msx-consulting/amino/mom-s1/PCB/Output/MoM-S1_schematic_v1.0.6.pdf

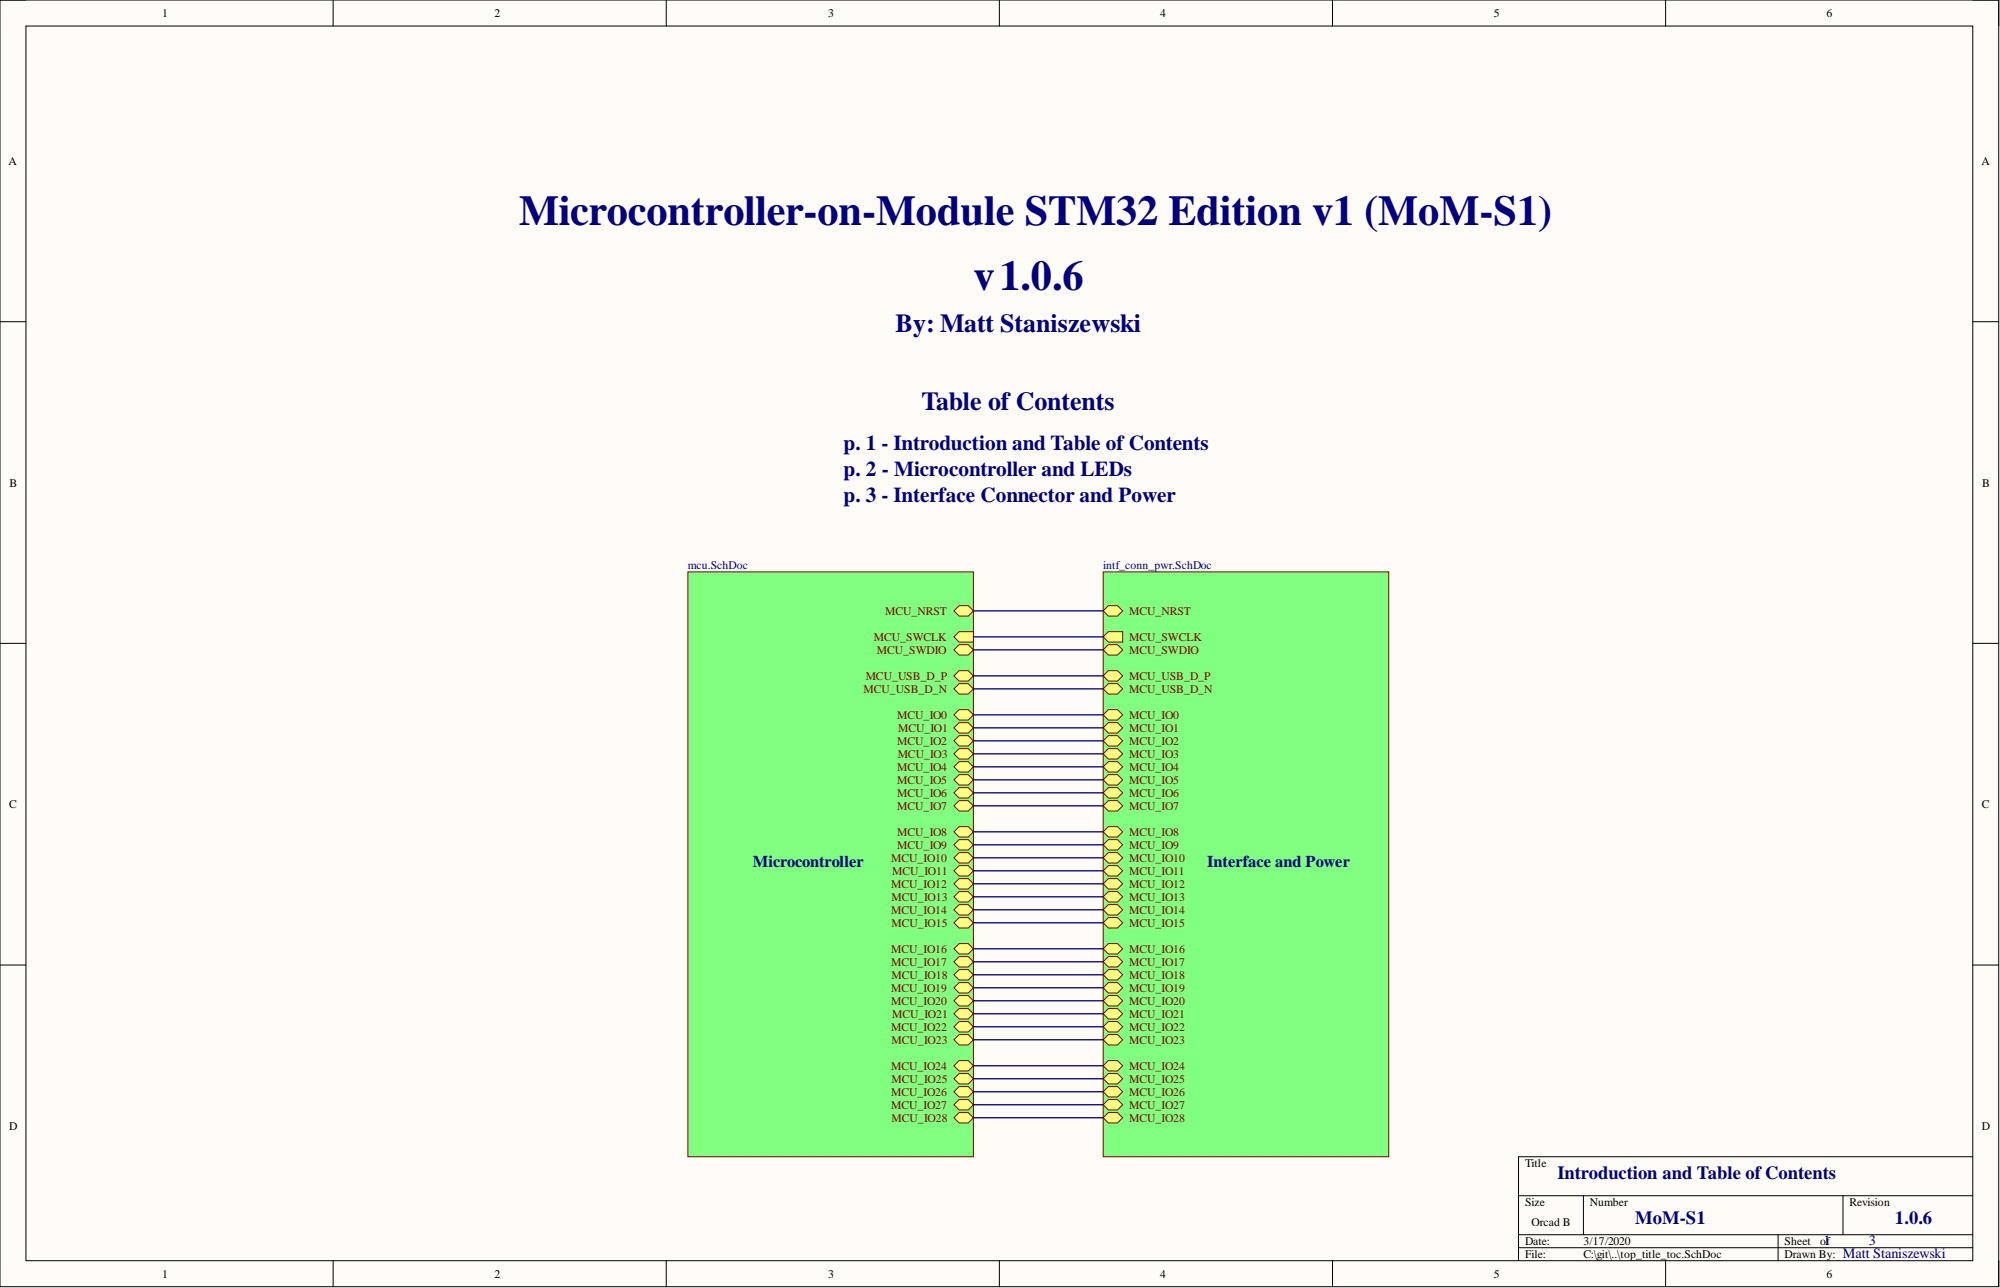
[picture p6: page 1]

Microcontroller-on-Module STM32 Edition v1 (MoM-S1)

p. 1 - Introduction and Table of Contents
p. 2 - Microcontroller and LEDs
p. 3 - Interface Connector and Power

Title
Introduction and Table of Contents

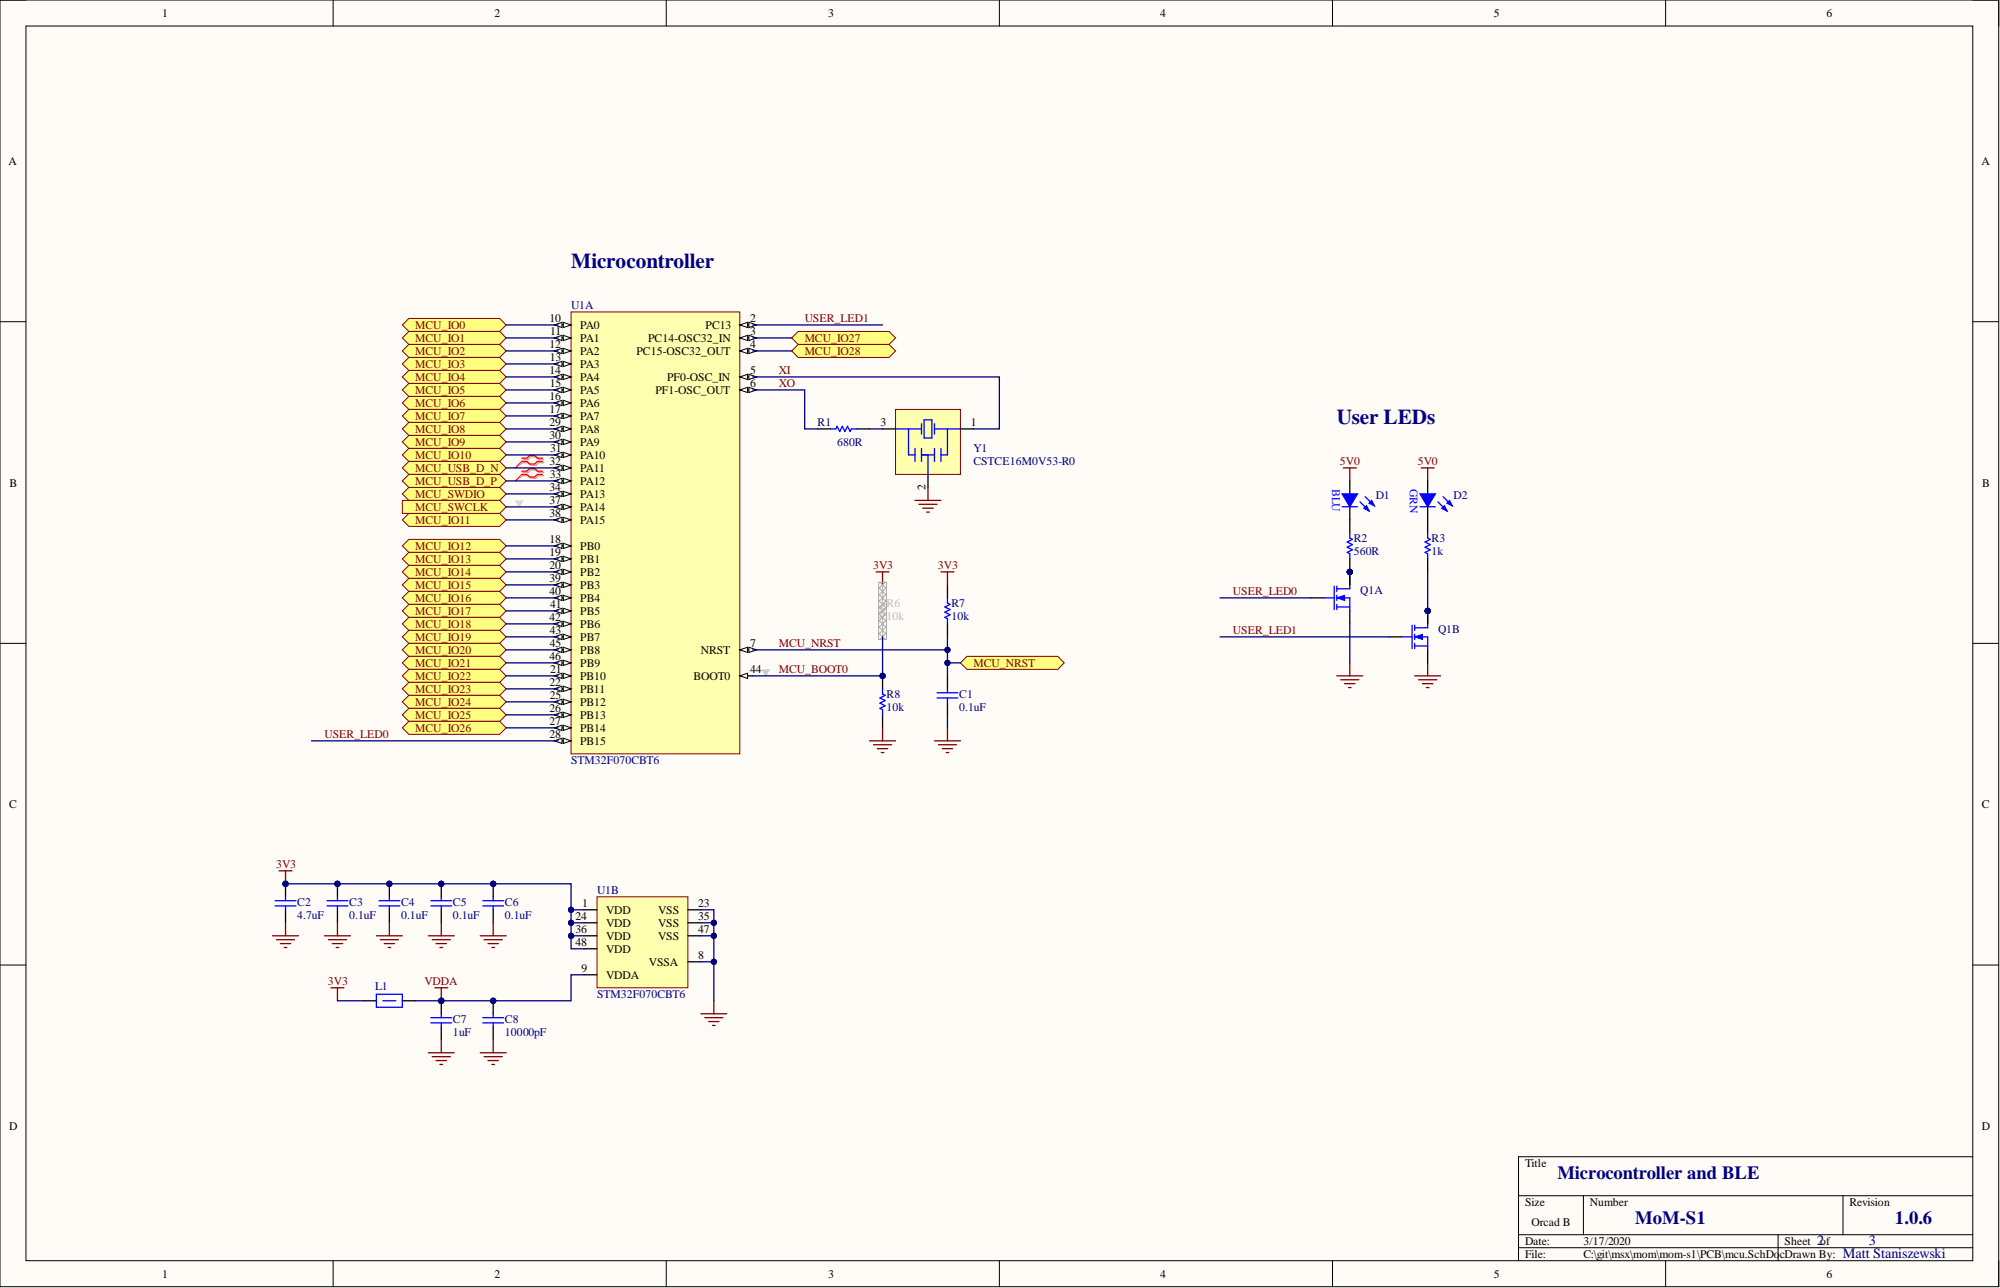
[picture p7: page 2]

MCU_NRST

MCU_BOOT0

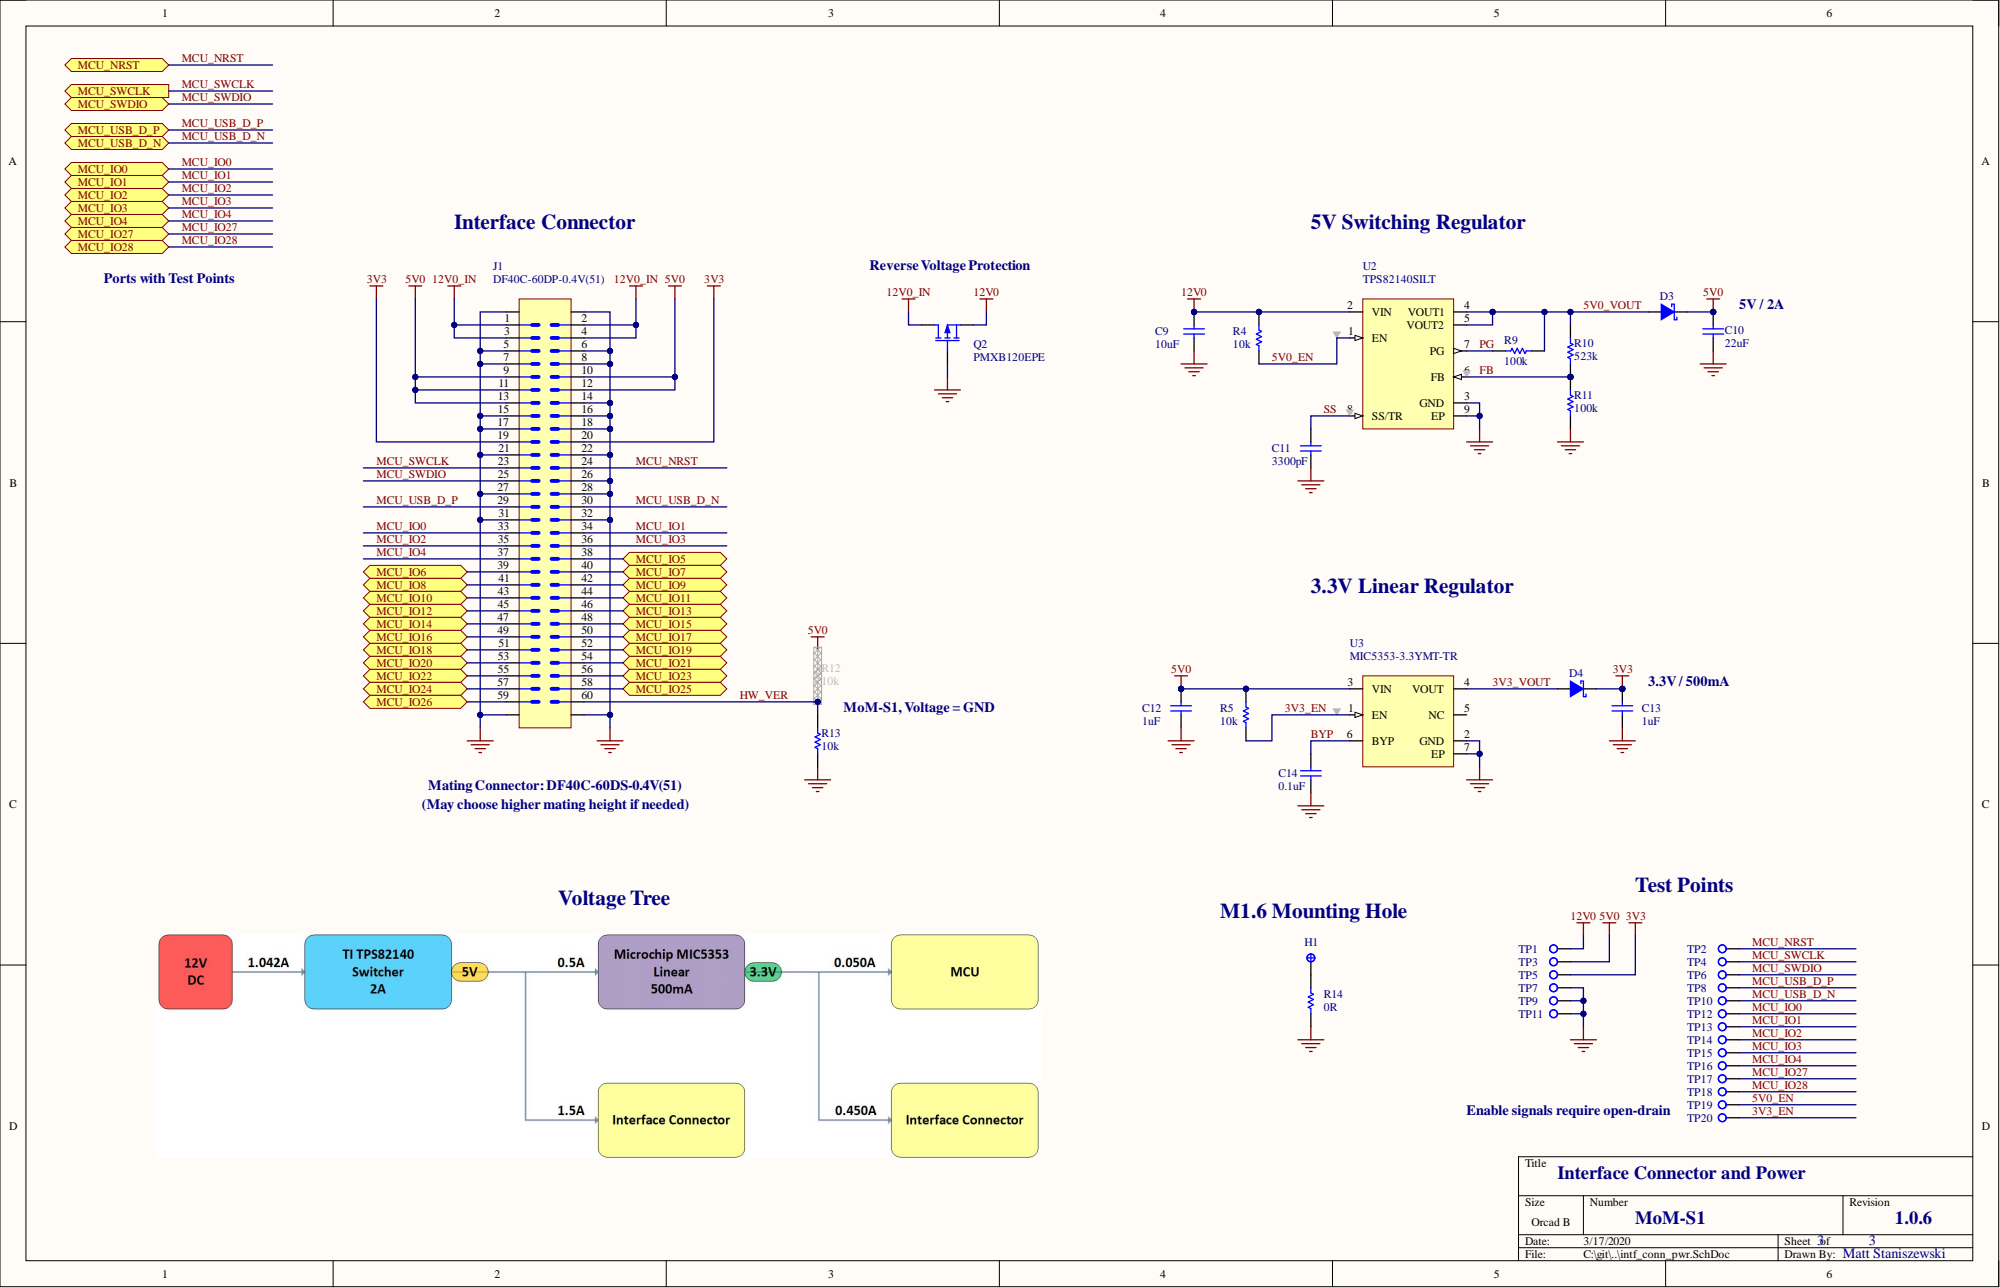
[picture p8: page 3]

Ports with Test Points

BYP

Mating Connector: DF40C-60DS-0.4V(51)
(May choose higher mating height if needed)

Title
Interface Connector and Power
