msx-consulting/amino/mom-s1/PCB/Output/MoM-S1_schematic_v1.0.3.pdf

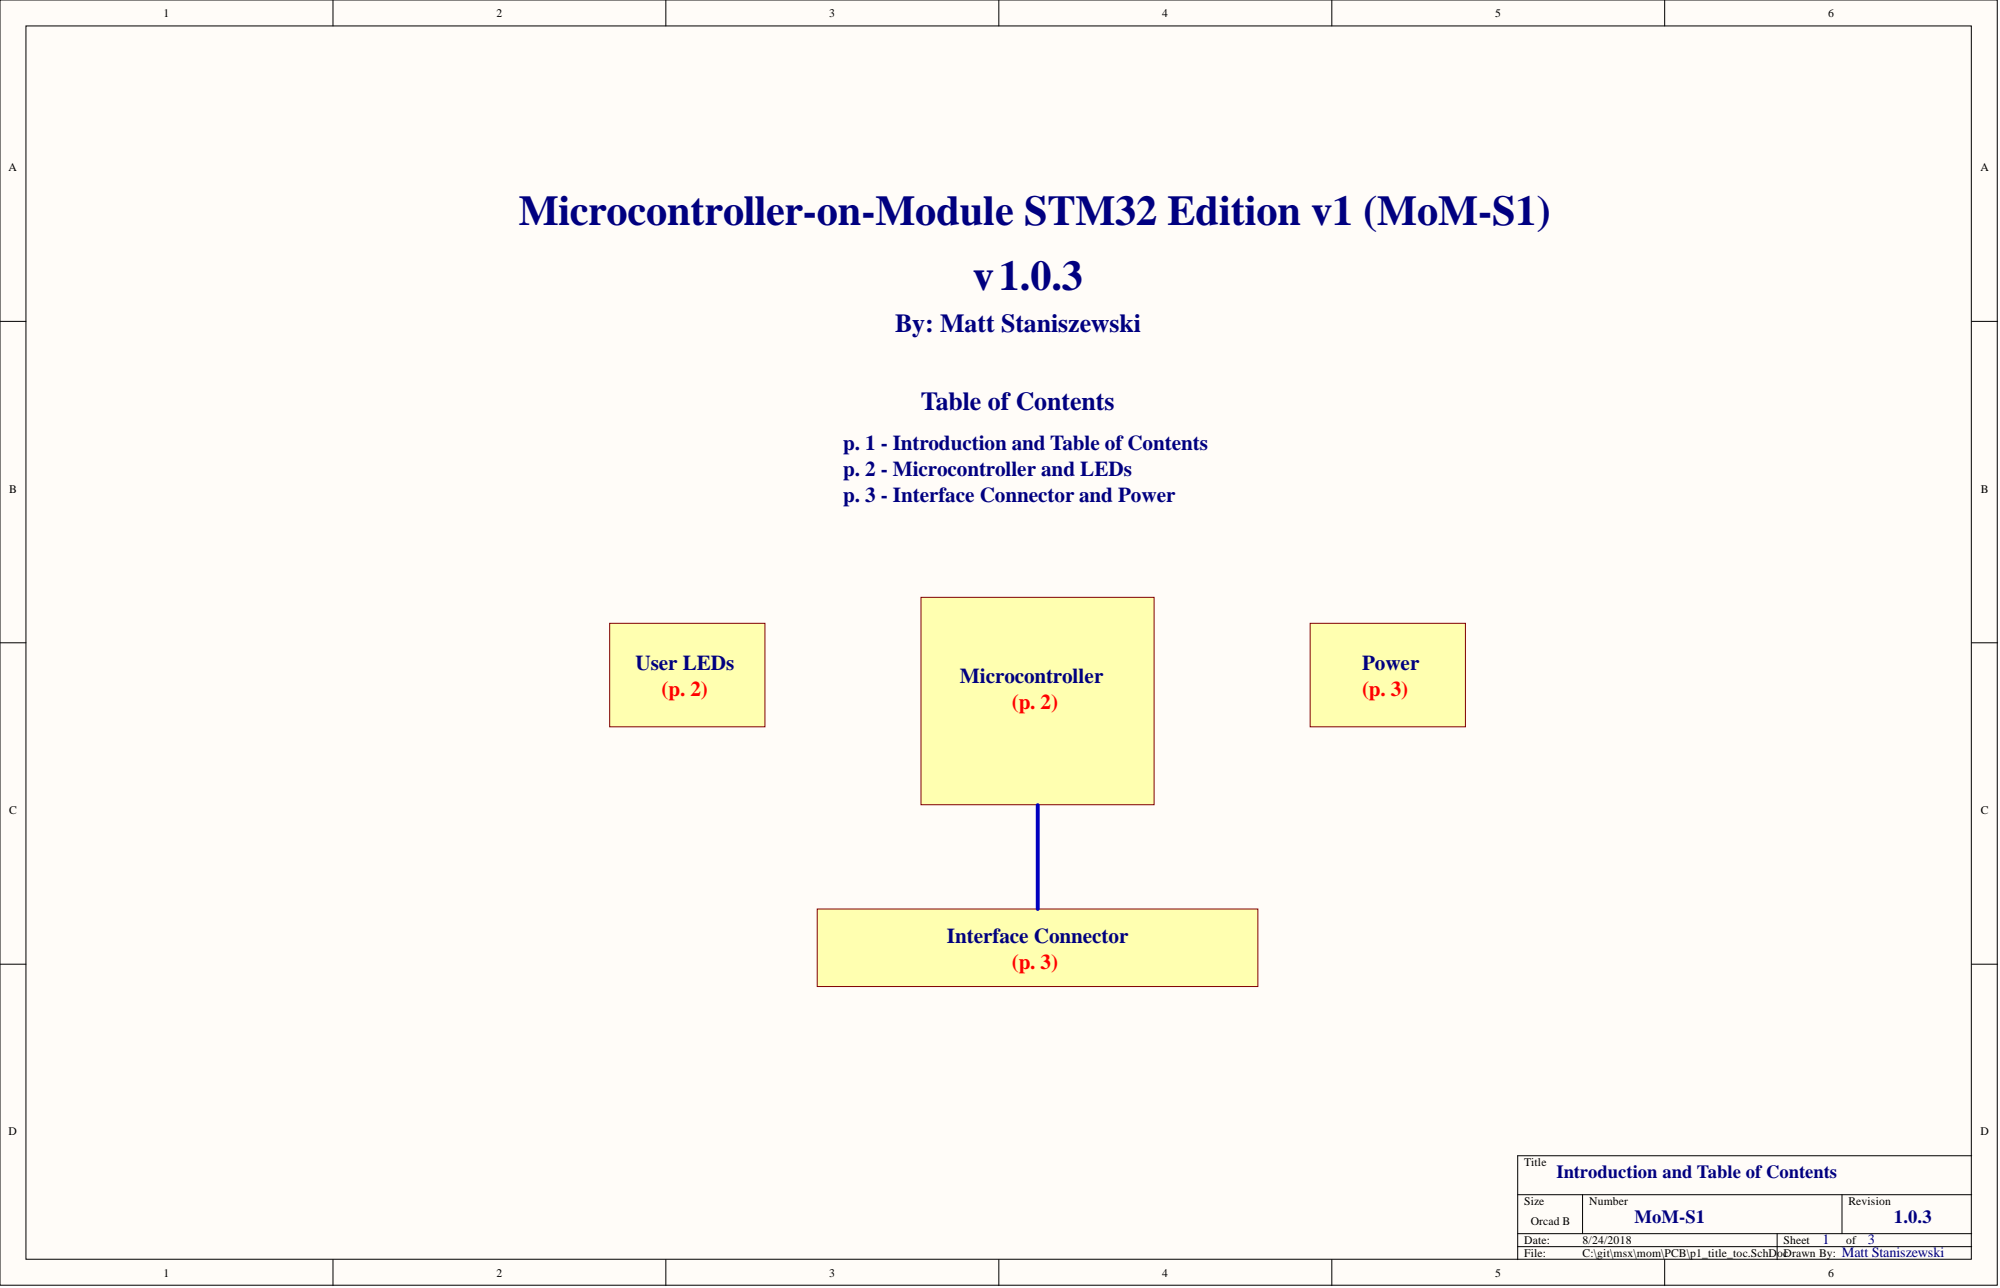
[picture p15: page 1]

Microcontroller-on-Module STM32 Edition v1 (MoM-S1)

p. 1 - Introduction and Table of Contents
p. 2 - Microcontroller and LEDs
p. 3 - Interface Connector and Power

Title
Introduction and Table of Contents

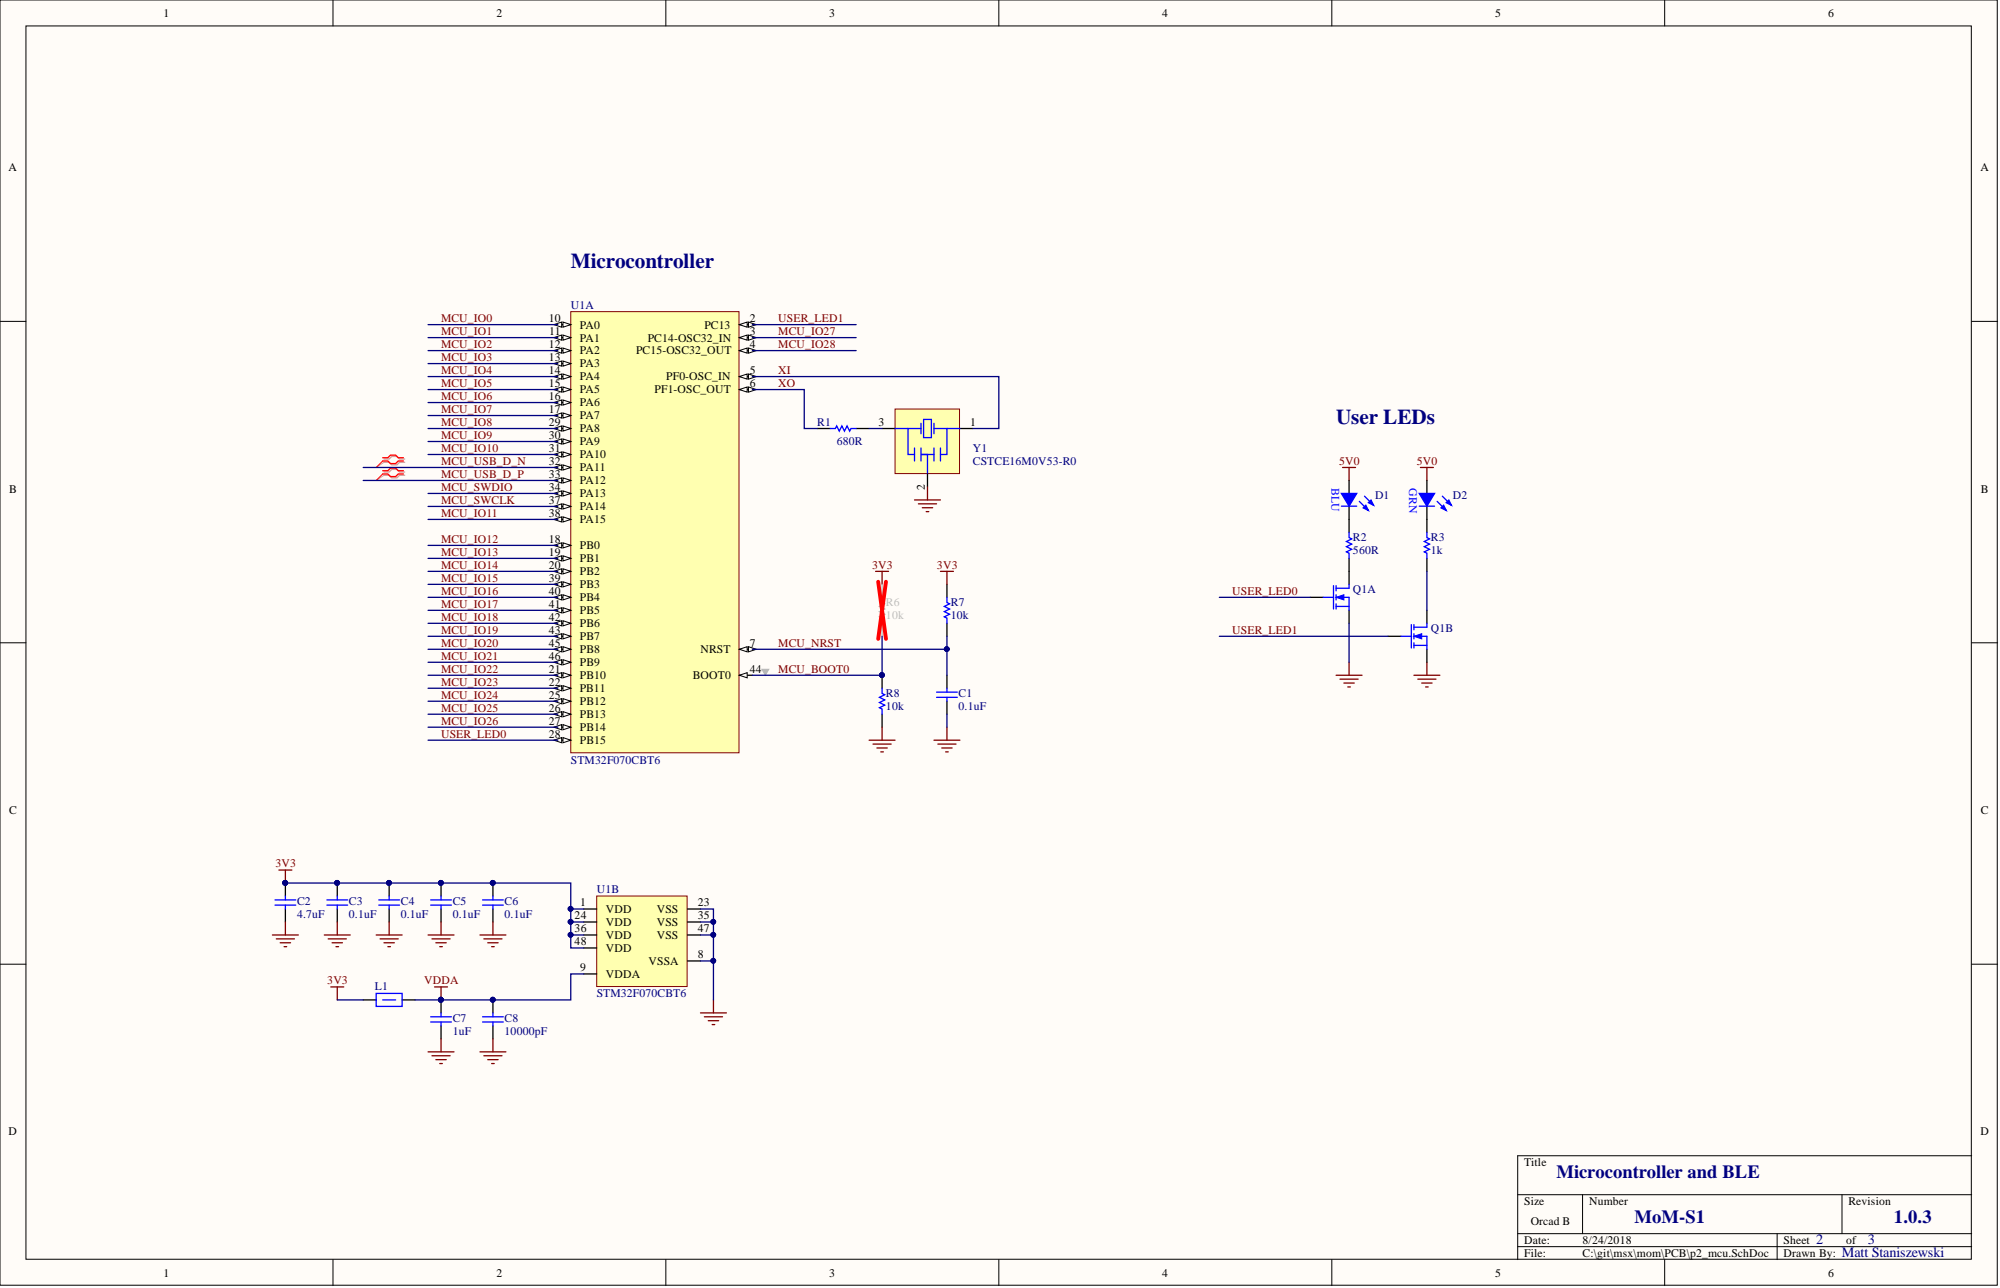
[picture p16: page 2]

7 MCU _ NRST

4 4 MCU _BO O T 0

2 4 | 3 5
3 6 | 4 7
4 8 | 8

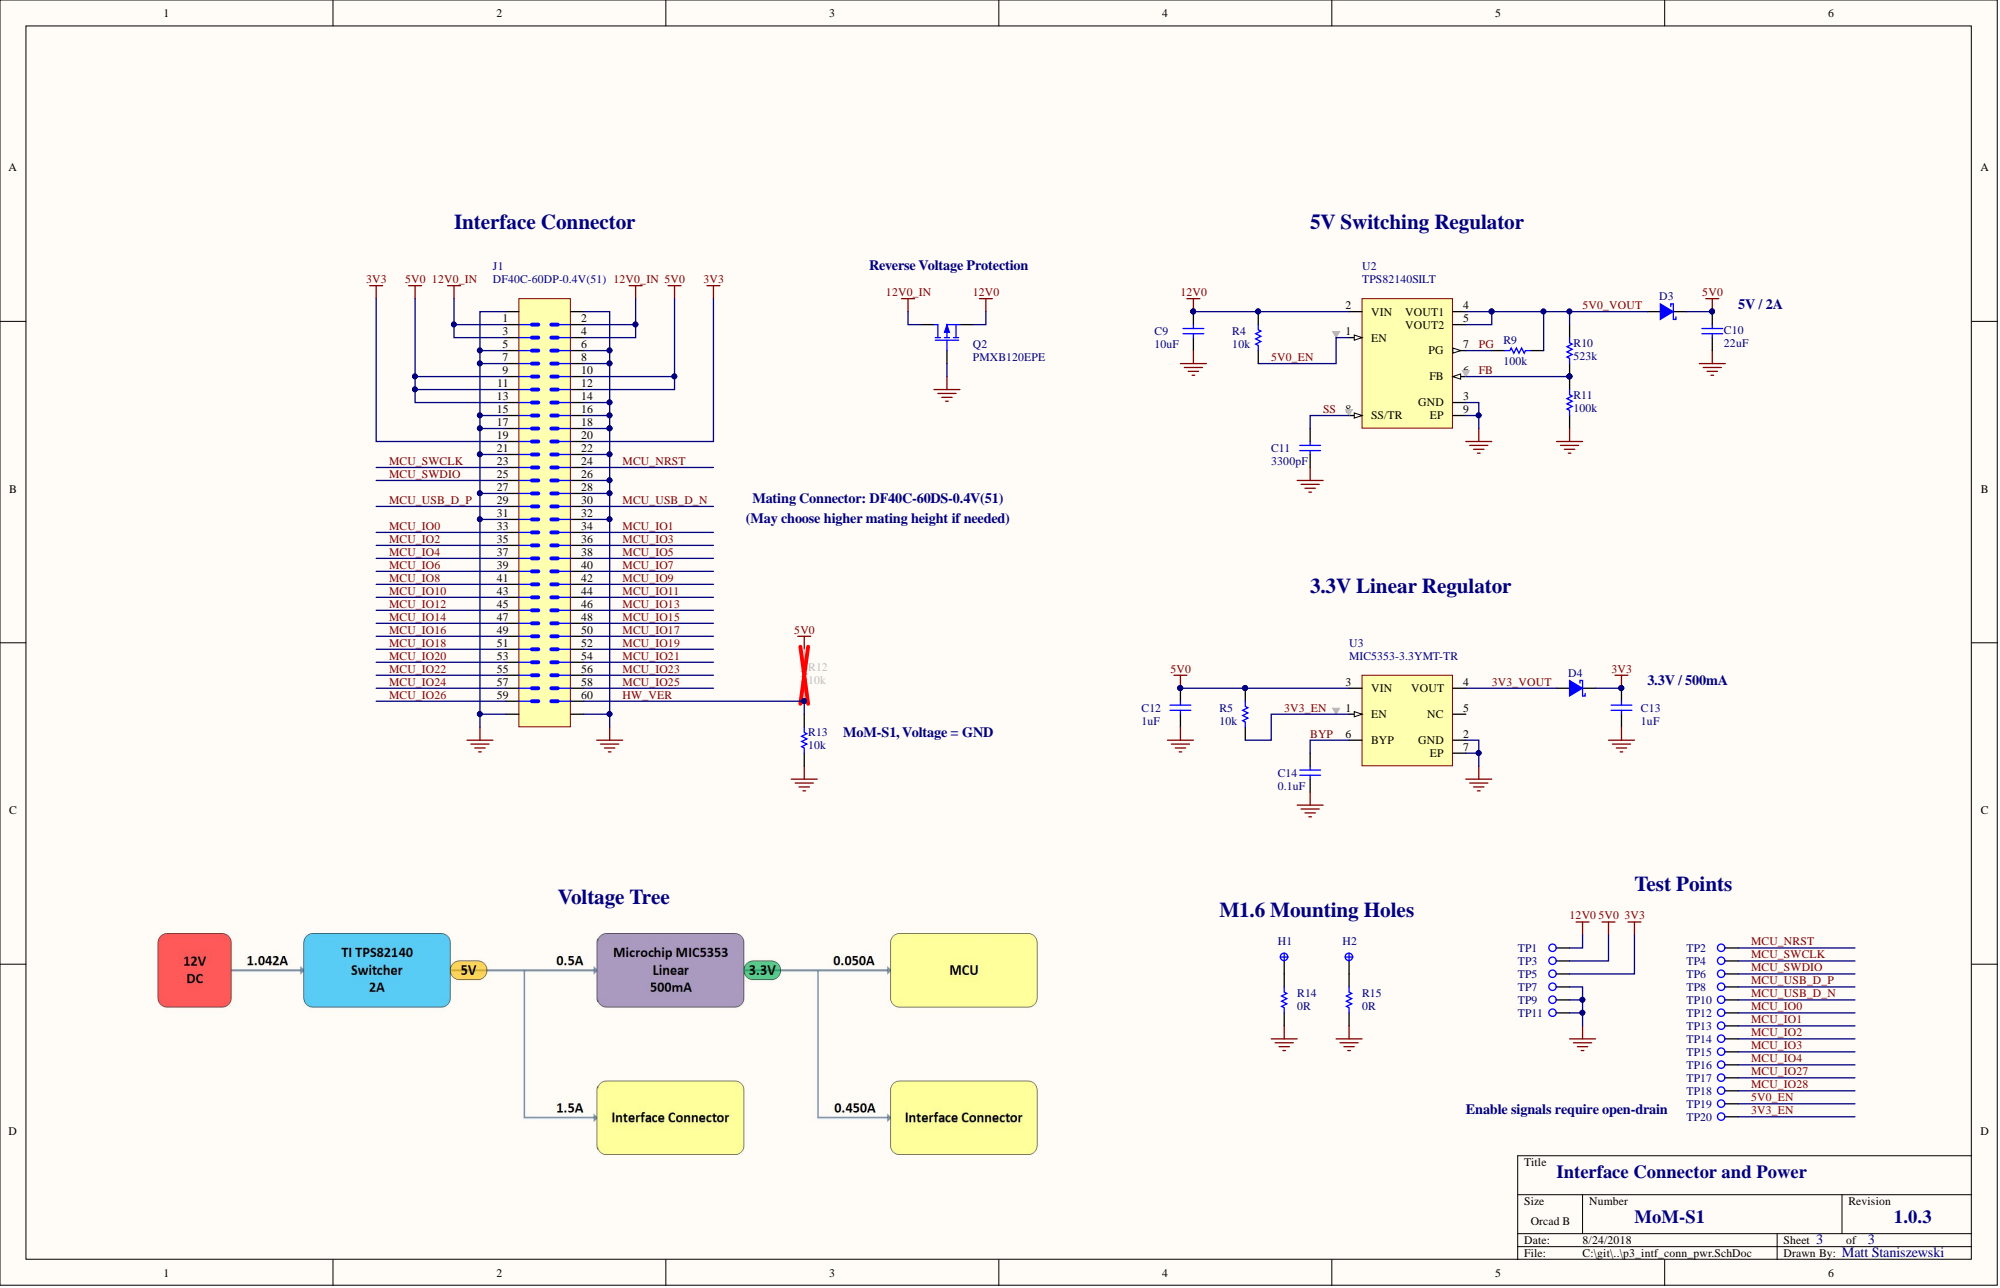
[picture p17: page 3]
