msx-consulting/amino/(list of files, drawings)

Other design files:
mom-s1/PCB/intf_conn_pwr.SchDoc
mom-s1/PCB/mcu.SchDoc
mom-s1/PCB/mom-s.PcbDoc
mom-s1/PCB/mom-s.PrjPcb
mom-s1/PCB/top_title_toc.SchDoc
UPDATE PCB/amino.PrjPcb
UPDATE PCB/p1_title_toc.SchDoc
UPDATE PCB/p2_mcu_ble.SchDoc
UPDATE PCB/p3_intf_conn_pwr.SchDoc
