msx-consulting/amino/(commit log)

2017-09-19 Move git repo from personal to MSX
    [Interface Connector Pinout.xlsx]
2017-09-19 Added Hisory to ignore
    [amino.PrjPcb, p1_title_toc.SchDoc, p2_mcu_ble.SchDoc, p3_intf_conn.SchDoc, p4_pwr_misc.SchDoc]
2017-09-19 Add schmatic page structure
    [amino.PrjPcb, p2_mcu_ble.SchDoc, p3_intf_conn.SchDoc, p4_pwr_misc.SchDoc]
2017-09-19 Started wiring up MCU
    [amino.PrjPcb, p1_title_toc.SchDoc, p2_mcu_ble.SchDoc, p3_intf_conn.SchDoc, p4_pwr_misc.SchDoc]
2017-09-20 FTDI chip hooked up for USB UART
    [Interface Connector Pinout.xlsx, amino.PrjPcb, p1_title_toc.SchDoc, p2_mcu_ble.SchDoc, p3_intf_conn.SchDoc, p4_pwr_misc.SchDoc]
2017-09-22 Sch in progress
    [p1_title_toc.SchDoc, p2_mcu_ble.SchDoc, p3_intf_conn.SchDoc, p4_pwr_misc.SchDoc]
2017-09-23 Cleaning up sch, almost done with Amino
    [amino.PrjPcb, p1_title_toc.SchDoc, p2_mcu_ble.SchDoc, p3_intf_conn.SchDoc, p3_intf_conn_pwr.SchDoc, p4_pwr_misc.SchDoc]
2017-09-23 More elegant USB power solution added
    [amino.PrjPcb, p2_mcu_ble.SchDoc]
2017-09-26 Notes review completed, prep for netlist review
    [Interface Connector Pinout.xlsx, amino.PrjPcb, p1_title_toc.SchDoc, p2_mcu_ble.SchDoc, p3_intf_conn_pwr.SchDoc]
2017-09-26 amINO (v1.0.1): Netlist review completed
    [amino.PrjPcb, p1_title_toc.SchDoc, p2_mcu_ble.SchDoc, p3_intf_conn_pwr.SchDoc]
2017-10-01 PCB started, stackup and rules done, placing
    [amino.PcbDoc, amino.PrjPcb, p1_title_toc.SchDoc, p2_mcu_ble.SchDoc, p3_intf_conn_pwr.SchDoc]
2017-10-10 Rough placement done, v1.0.2 in progress
    [amino.PcbDoc, amino.PrjPcb, p1_title_toc.SchDoc, p2_mcu_ble.SchDoc, p3_intf_conn_pwr.SchDoc]
2017-10-11 amINO (v1.0.2): Updates for placement
    [Bill of Materials-amino.csv, amino.PcbDoc, amino.PrjPcb, amino.xls, p1_title_toc.SchDoc, p2_mcu_ble.SchDoc, p3_intf_conn_pwr.SchDoc]
2017-10-17 Sync up for big compy
    [amino.PcbDoc, amino.PrjPcb, p2_mcu_ble.SchDoc]
2017-10-17 v1.0.3 in progress, C8 footprint changed
    [amino.PcbDoc, amino.PrjPcb, p1_title_toc.SchDoc, p2_mcu_ble.SchDoc, p3_intf_conn_pwr.SchDoc]
2017-10-31 Working on planes
    [amino.PcbDoc, amino.PrjPcb, p2_mcu_ble.SchDoc, p3_intf_conn_pwr.SchDoc]
2017-11-05 Swapping and fanning out the BGA
    [Interface Connector Pinout.xlsx, amino.PcbDoc, amino.PrjPcb, p1_title_toc.SchDoc, p2_mcu_ble.SchDoc, p3_intf_conn_pwr.SchDoc]
2017-11-05 Prep to remove USB power switch
    [amino.PcbDoc, p2_mcu_ble.SchDoc]
2017-11-05 Tossed USB switch, fixing AVCC, other rails
    [amino.PcbDoc, p1_title_toc.SchDoc, p2_mcu_ble.SchDoc, p3_intf_conn_pwr.SchDoc]
2018-05-11 Review notes, begin transition to MoM design
    [Interface Connector Pinout.xlsx]
2018-05-12 Read through MCU and associated specs
    [Select_BXLfile.xls]
2018-05-12 More updates for transition
    [Bill of Materials-amino.csv, amino.PcbDoc, amino.PrjPcb, amino.xls, p1_title_toc.SchDoc, p2_mcu_ble.SchDoc, p3_intf_conn_pwr.SchDoc]
2018-05-13 Prep to redo sch
    [amino.PcbDoc, mom-s.PrjPcb, p1_title_toc.SchDoc, p2_mcu_ble.SchDoc, p3_intf_conn_pwr.SchDoc]
2018-05-13 Cleaned out old sch
    [mom-s.PrjPcb, p1_title_toc.SchDoc, p2_mcu.SchDoc, p2_mcu_ble.SchDoc, p3_intf_conn_pwr.SchDoc]
2018-05-13 v1.0.0 schematic generated to be checked
    [Interface Connector Pinout.xlsx, mom-s.PrjPcb, p1_title_toc.SchDoc, p2_mcu.SchDoc, p3_intf_conn_pwr.SchDoc]
2018-05-13 Started playing with PCB, need to add rules
    [mom-s.PcbDoc, mom-s.PrjPcb]
2018-05-14 Updated old rules, guidelines and stackup
    [mom-s.PcbDoc, mom-s.PrjPcb]
2018-07-21 Added PCBLib changes
    [mom-s.PcbDoc]
2018-08-03 MoM-S Schematic (v1.0.1): Removed 2 LEDs, added testpoints
    [mom-s.PcbDoc, mom-s.PrjPcb, p1_title_toc.SchDoc, p2_mcu.SchDoc, p3_intf_conn_pwr.SchDoc]
2018-08-25 MoM-S1 Schematic (v1.0.2): Added protection circuitry
    [mom-s.PcbDoc, mom-s.PrjPcb, p1_title_toc.SchDoc, p2_mcu.SchDoc, p3_intf_conn_pwr.SchDoc]
2018-08-25 MoM-S1 Schematic (v1.0.3): Fixed Typo, Spec Updates
    [mom-s.PcbDoc, mom-s.PrjPcb, p1_title_toc.SchDoc, p2_mcu.SchDoc, p3_intf_conn_pwr.SchDoc]
2018-08-25 Fix schematic and netlist naming
2018-09-05 MoM-S1 Schematic (v1.0.4): Removed mounting hole
    [mom-s.PcbDoc, mom-s.PrjPcb, p1_title_toc.SchDoc, p2_mcu.SchDoc, p3_intf_conn_pwr.SchDoc]
2018-11-30 MoM-S1 Schematic (v1.0.5): Switch to Hierarchical Design
    [Select_BXLfile.xls, intf_conn_pwr.SchDoc, mcu.SchDoc, mom-s.PcbDoc, mom-s.PrjPcb, p1_title_toc.SchDoc, p2_mcu.SchDoc, p3_intf_conn_pwr.SchDoc]
2018-11-30 Changed file structure to include multiple boards
    [Interface Connector Pinout.xlsx, Select_BXLfile.xls, intf_conn_pwr.SchDoc, mcu.SchDoc, mom-s.PcbDoc, mom-s.PrjPcb, top_title_toc.SchDoc]
2018-11-30 Renamed files
    [MoM-S1 Interface Connector Pinout.xlsx]
2019-03-14 Switching gears again
    [Select_BXLfile.xls]
2020-03-17 MoM-S1 Schematic (v1.0.6): Fixed Bad PMDXB600UNE Symbol
    [intf_conn_pwr.SchDoc, mcu.SchDoc, mom-s.PcbDoc, mom-s.PrjPcb, top_title_toc.SchDoc]
